lanacif/Single-Point-LiDAR-Scanner/imgs/Resultado1.png

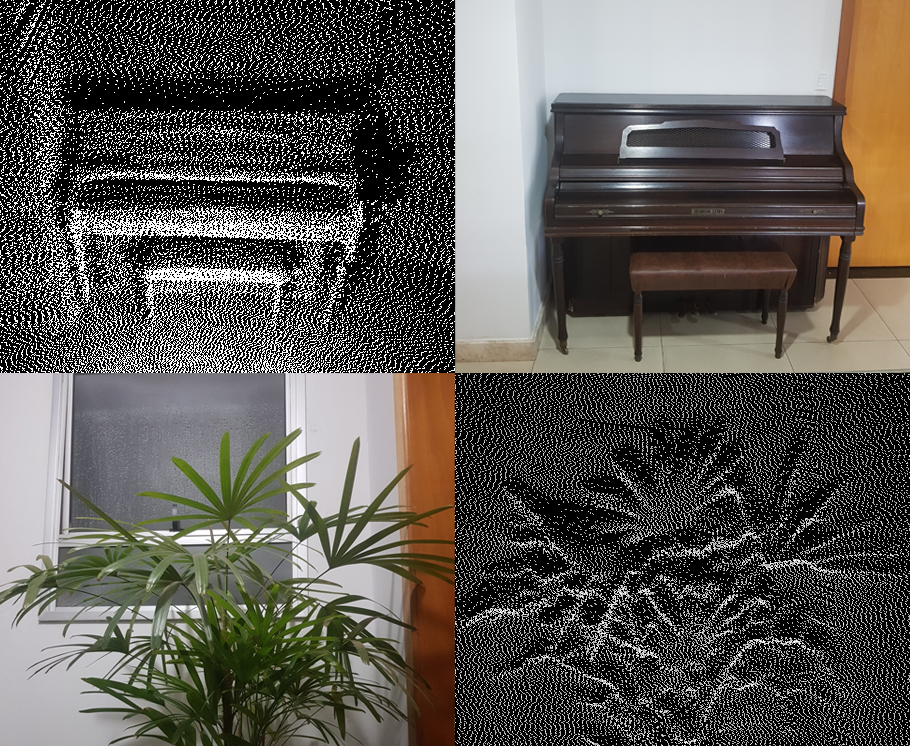
imgs/Resultado1.png
