lanacif/Single-Point-LiDAR-Scanner/README.md

# Single-Point-LiDAR-Scanner
Este repositório contém o código e os recursos necessários para o desenvolvimento de um protótipo de scanner LiDAR terrestre estacionário de ponto único, projetado para estudos e mapeamento de ambientes em pequena escala.
