lanacif/Single-Point-LiDAR-Scanner/Artigos Guia/TCC2.pdf

Centro Federal de Educaçao Tecnol ˜ | ogica de Minas Gerais – CEFET-MG ´ | 1
Construçao e Caracterizaç ˜ | ao de Sensores LiDAR no ˜

# Mapeamento 3D de Ambientes

Lucas Augusto Nacif Moura, CEFET-MG

Resumo—Este estudo descreve o desenvolvimento e a
implementaçao de um prot ˜ | otipo de scanner LiDAR terrestre ´
estacionario, que foi utilizado para avaliar o impacto do aliasing ´
espacial em funçao da resoluç ˜ | ao espacial e da dist ˜ | ancia de ˆ
mediçao. Experimentos realizados a dist ˜ | ancias de 1 m, 2 m ˆ
e 4 m revelaram uma tendencia de incremento do aliasing ˆ
com o aumento da distancia, evidenciando a correlaç ˆ | ao entre a ˜
distancia de mediç ˆ | ao e diminuiç ˜ | ao da resoluç ˜ | ao espacial. Esta ˜
constataçao ressalta a import ˜ | ancia de uma escolha criteriosa ˆ
da taxa de amostragem para assegurar a integridade do sinal amostrado. Complementando os achados experimentais, coletas realizadas com o prototipo realçam sua capacidade de criar ´ nuvens de pontos detalhadas, enfatizando sua eficacia na captura ´ dos detalhes mais relevantes dos ambientes mapeados. Diante dos resultados obtidos, este trabalho oferece uma compreensao dos ˜ desafios associados ao aliasing espacial, especialmente no contexto de scanners LiDAR terrestres estacionarios. Paralelamente, o ´
prototipo desenvolvido se destaca por sua efic ´ | acia, demonstrando ´
um equilíbrio otimizado entre custo, desempenho, funcionalidade, leveza e capacidade de transmissao de dados em tempo real. ˜ Index Terms—Scanner LiDAR, Stationary Terrestrial, Aliasing, Resolution.
I. INTRODUÇ AÕ
A

tecnologia LiDAR (Light Detection and Ranging) é uma maneira de capturar e interpretar dados espaciais,
gerando representaçoes tridimensionais realistas atrav ˜ | es de ´
nuvens de pontos. Utilizada em diversas areas como engenha- ´ ria civil, arqueologia, monitoramento ambiental, mineraçao e ˜ agricultura, a tecnologia LiDAR proporciona um mapeamento detalhado e versatil do ambiente. ´
Embora a necessidade de exigencia de precis ˆ | ao possa va- ˜
riar significativamente entre diferentes aplicaçoes, a resoluç ˜ | aõ
espacial e um atributo fundamental em levantamentos usando ´ scanners LiDAR. A resoluçao espacial determina quais de- ˜
talhes sao identific ˜ | aveis em uma nuvem de pontos obtida ´
por escaneamento LiDAR. O conhecimento correto desta
resoluçaõ e necess ´ | ario para prevenir o aliasing, permitindo ´
uma avaliaçao de quais detalhes que podem ser capturados da ˜ nuvem de pontos.
Conforme Lichti [1], a resoluçao em scanners LiDAR ˜ e frequentemente mal interpretada e calculada de maneira ´

Lucas Augusto Nacif Moura, (http://lattes.cnpq.br/1147778298578569) Belo Horizonte, Minas Gerais (lanacif@hotmail.com)
Trabalho de Conclusao de Curso submetido em 04/12/2023 e orientado ˜ pelo Dr. Everthon de Souza Oliveira, (http://lattes.cnpq.br/5508538577119686) e coorientado pelo Dr. Tulio Charles ´ de Oliveira Carvalho (http://lattes.cnpq.br/0249563467742892) integrantes do Departamento de Engenharia Eletrica (http://www.eng-eletrica.bh.cefetmg.br/) do ´ (http://www.eng-eletrica.bh.cefetmg.br/)
Centro Federal de Educaçao Tecnol ˜ | ogica de Minas Gerais. ´ (https://www.cefetmg.br/)
“E nao vos conformeis com este mundo, mas transformai-vos pela renovaç ˜ | aõ
do vosso entendimento, para que experimenteis qual seja a boa, agradavel e ´ perfeita vontade de Deus.” Romanos 12:2
incorreta. E destacado que a ´ | enfase excessiva ˆ | e comumente co- ´
locada no menor intervalo de amostragem possível, ignorando fatores cruciais como a largura do feixe do laser. Tal malentendido atribui erroneamente uma alta resoluçao espacial ˜ em nuvens de pontos escaneadas, mesmo quando a largura do feixe compromete a qualidade da resoluçao. Para evitar ˜ tais equívocos e fornecer uma compreensao mais apropriada e ˜ abrangente da resoluçao em scanners a laser, Lichti [1] intro- ˜ duz um novo metodo chamado “Effective Instantaneous Field ´
of View” (EIFOV). Esse metodo prop ´ | | oe integrar consideraç ˜ | oes ˜
da largura do feixe e do intervalo de amostragem para uma
avaliaçao mais exata da resoluç ˜ | ao. ˜
Sendo assim, este trabalho dedica-se a explorar e analisar a metodologia empregada no desenvolvimento de um scanner
LiDAR terrestre estacionario de ponto ´ | unico, sem ecos e sem ´
uma unidade de GPS. A preocupaçao com a economia de ˜
recursos sao caracter ˜ | ísticas marcantes do aparato desenvolvido
e examinado. Apos essa fase inicial, a investigaç ´ | ao avança ˜
para uma analise do fen ´ | omeno do aliasing espacial, uma ˆ
consideraçao essencial para a compreens ˜ | ao das operaciona- ˜
lidades e limitaçoes inerentes ao dispositivo. ˜
Na sequencia, uma avaliaç ˆ | aõ e conduzida sobre o prot ´ | | otipo ´
desenvolvido, utilizando-se o metodo EIFOV para estabelecer ´
a resoluçao. Complementando a investigaç ˜ | ao, um teste pr ˜ | atico ´
e realizado com o objetivo de observar a ocorr ´ | encia e a ˆ
manifestaçao do efeito aliasing no contexto de mediç ˜ | | | oes ˜
LiDAR.
II. ASPECTOS TECNICOS E ´ | OPERACIONAIS DO SCANNER
| LIDAR
A. Scanner LiDAR Aereo e Terrestre: A Tecnologia e ´ Princípios Basicos ´
O sistema LiDAR, frequentemente utilizado em aeronaves de asa fixa, compreende um scanner com emissor e receptor de laser. Ele e integrado a um Sistema de Posicionamento ´ Global (GPS) para medir continuamente a localizaçao do ˜ scanner, essencial na determinaçao da origem dos pulsos laser. ˜
Alem disso, uma Unidade de Mediç ´ | ao Inercial (IMU) ˜ | e usada ´
para monitorar as variaçoes angulares da aeronave, como ˜ rolamento, arfagem e guinada, fornecendo dados para calcular
a orientaçao da aeronave e, por extens ˜ | ao da direç ˜ | ao dos pulsos ˜
emitidos [12].
Para compreender os princípios do LiDAR, e instrutivo ´ observar o trajeto de um pulso de luz individual. Este pulso é
formado por fotons cronometrados, disparados em uma direç ´ | | | aõ
predeterminada. Ao interagir com um objeto, como uma folha
na floresta, uma fraçao dos f ˜ | otons ´ | e refletida em direç ´ | aõ à
Trabalho de Conclusao de Curso - Engenharia El ˜ | etrica ´

Centro Federal de Educaçao Tecnol ˜ | ogica de Minas Gerais – CEFET-MG ´ | 2

fonte laser. O sistema LiDAR detecta esses fotons refletidos, ´ registrando o momento de seu retorno e calculando o intervalo
de tempo desde sua emissao at ˜ | e a recepç ´ | ao. Este processo ˜ | é
conhecido como ”eco”, originado do pulso emitido. Usando a velocidade conhecida do pulso (equivalente a velocidade da `
luz), o local de emissao, a direç ˜ | ao e o tempo de viagem do ˜
pulso, o LiDAR determina o ponto de origem do eco. [12]. Os pulsos de luz podem gerar multiplos retornos luminosos, ´ pois alguns feixes penetram materiais parcialmente transparentes antes de refletir em outros objetos. Esses ecos saõ classificados em quatro categorias: “primeiro de muitos” (o
primeiro eco dentre varios), “ ´ | ultimo de muitos” (o ´ | ultimo eco), ´
“intermediario” (ecos entre o primeiro e o ´ | ultimo) e “ ´ | unico” ´
(quando apenas um eco e detectado a partir de um pulso) [12]. ´
A localizaçao de cada eco ˜ | e registrada, associando-se ´ | as`
coordenadas XYZ correspondentes. Esses dados coletados saõ comumente processados sob a forma de uma nuvem de pontos.
Mediante a representaçao gr ˜ | afica desses dados, torna-se vi ´ | avel ´
a visualizaçao da estrutura do objeto que passou pelo processo ˜ de digitalizaçao [12]. ˜
Embora o scanner LiDAR aereo seja uma ferramenta po- ´ derosa para a captaçao de dados em grande escala, sua ˜ contraparte terrestre oferece uma perspectiva complementar.
Os fundamentos da mediçao de dist ˜ | ancia a laser e varredura ˆ
apresentados se aplicam tanto a sistemas aereos quanto a ´ sistemas terrestres.
A tecnologia LiDAR terrestre, oferece um nível de detalhe
e precisao distintos. Enquanto o LiDAR a ˜ | ereo ´ | e ideal para ´
mapeamentos de grande escala e analises extensas de ´ | areas, o ´
LiDAR terrestre se destaca em levantamentos mais detalhados em escalas menores. Frequentemente utilizado em projetos de engenharia, arquitetura e arqueologia, o LiDAR terrestre opera
com scanners montados em tripes ou plataformas m ´ | oveis, per- ´
mitindo mediçoes detalhadas e de alta resoluç ˜ | ao de estruturas, ˜
terrenos e objetos proximos. Esta tecnologia complementar ´
amplia a capacidade de analise e representaç ´ | ao do mundo ˜
físico.
Enquanto os scanners a laser aereos necessitam apenas ´ de uma direçao de varredura, com a outra realizada pelo ˜ movimento da aeronave, os terrestres normalmente empregam um sistema de varredura 2D. Ha tr ´ es tipos principais: janela ˆ (usualmente operados por dois espelhos de galvanometro, ˆ
oferecendo um campo de visao retangular), panor ˜ | amicos (com ˆ
visao horizontal de 360 graus e vertical tipicamente entre 80 a ˜ 90 graus, frequentemente utilizando uma roda poligonal para a varredura vertical e uma rotaçao horizontal completa do ˜ dispositivo. A substituiçao da roda poligonal por um sistema ˜ de varredura Palmer expande o campo de visao, sendo limitado ˜
somente pelas auto-oclusoes do instrumento e do trip ˜ | e que o ´
suporta) e (hemi)esfericos [13]. ´
B. Fundamento do Funcionamento de um Scanner LiDAR Estacionario ´
Conforme apresentado, os sistemas de varredura a laser
funcionam atraves da emiss ´ | ao de feixes de luz intensos e ˜
focalizados, realizando mediçoes baseadas no tempo requerido ˜
para a captura dos reflexos pelo sensor. Essas informaçoes s ˜ | aõ
empregadas na determinaçao das dist ˜ | ancias em relaç ˆ | ao aos ˜
objetos analisados. As coordenadas tridimensionais desses ob-
jetos sao estabelecidas levando em consideraç ˜ | ao os seguintes ˜
parametros: ˆ
1) A discrepancia temporal entre a emiss ˆ | ao e o retorno do ˜
pulso de laser,
2) o angulo espec ˆ | ífico em que o pulso de laser foi proje-
tado, e
3) a posiçao absoluta do sensor, situado na ou elevado ˜ acima da superfície terrestre [3].
Um escaneamento 3D de uma cena pode ser realizado movimentando mecanicamente o feixe de laser do telemetro ˆ em passos arcuais uniformes nos planos horizontal (∆θ) e vertical (∆α), conforme delineado por Besl [4]. Este procedimento permite a parametrizaçao da cena escaneada em ˜
termos de distancia, ˆ | ρ, sendo representada como uma funçaõ
uniformemente amostrada baseada na direçao horizontal, ˜ | θ, e
no angulo de elevaç ˆ | ao, ˜ | α:

ρs(θ, α) = X∞

m=−∞

X∞

n=−∞

ρc(m∆θ, n∆α)δ(θ−m∆θ, α−n∆α)

(1)
em que ρs representa a cena contínua ρc apos a amostragem, ´ e δ simboliza a funçao delta de Dirac. Os intervalos de amos- ˜ tragem espacial variam proporcionalmente com a distancia ˆ
medida. Assim, ρ∆θ e ρ∆α indicam essa variaçao na direç ˜ | aõ
horizontal e no angulo de elevaç ˆ | ao, respectivamente. ˜
A Figura 1 ilustra o exposto anteriormente. Na Figura, é evidenciado um plano retangular e as amostras obtidas no espaço tridimensional, com incrementos uniformes para θ e α.
O telemetro est ˆ | a centrado no ponto (0,0,0), que ´ | e destacado ´
na figura.

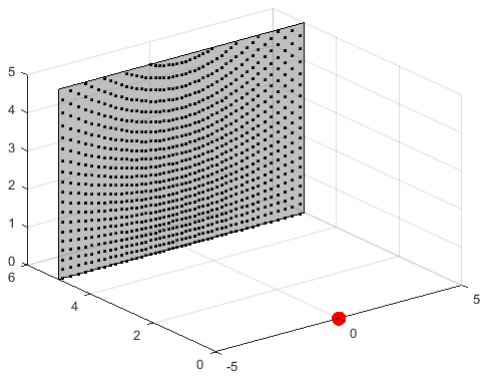
[picture p3: figure]

Figura 1. Visualizaçao tridimensional da amostragem pelo LiDAR, desta- ˜
cando a variaçao do espaçamento entre as amostras com a dist ˜ | ancia. ˆ
Este fenomeno ocorre devido ˆ | a depend ` | encia do espaçamento ˆ
entre os pontos, em termos de distancia linear, com a dist ˆ | ancia ˆ

Centro Federal de Educaçao Tecnol ˜ | ogica de Minas Gerais – CEFET-MG ´ | 3

do scanner. Proximamente ao LiDAR, uma alteraçao angular ˜ modesta pode resultar em um deslocamento linear relativa-
mente pequeno. Entretanto, a medida que a dist ` | ancia em ˆ
relaçao ao LiDAR aumenta, a mesma mudança angular pode ˜ levar a um deslocamento linear significativamente maior.

III. FUNDAMENTAÇ AÕ TEORICA ´

A. A Transformada Discreta de Fourier
Uma funçao cont ˜ ínua f(x) pode ser discretizada atraves de ´ uma serie de amostras, cada uma separada por um intervalo ´
∆x. A representaçao discreta dessa funç ˜ | aõ e expressa por: ´
f(x) = f(x0 + x∆x), | (2)
em que, neste contexto, x e uma vari ´ | avel discreta que assume ´
valores de 0 a N −1. Aqui, x0 e o ponto inicial de amostragem ´ e ∆x e o espaçamento entre as amostras, ambos sendo ´ valores constantes. Em termos simples, toma-se N amostras uniformemente espaçadas da funçao cont ˜ ínua correspondente. Dada a notaçao anterior, o par de transformadas discretas ˜
de Fourier para funçoes amostradas s ˜ | ao expressas por: ˜

F(u) = 1
N

N

X⁻¹

x=0

f(x)e

(−j2πux/N)
(3)

e

f(x) =

N

X⁻¹

u=0

F(u)e

(j2πux/N)
. | (4)
Na Equaçao 3, os valores de ˜ | u correspondem a amostras de
uma transformada contínua, isto e,´ F(u) = F(u∆u).
Os termos ∆u e ∆x estao relacionados pela seguinte ˜ expressao: ˜

∆u =

1
N∆x
. | (5)

Para um par de variaveis, o conjunto correspondente de ´ transformadas de Fourier e expresso como: ´

F(u, v) = 1
MN

M

X⁻¹

x=0

N

X⁻¹

y=0

f(x, y)e

−j2π(ux/M+vy/N)
(6)

e

f(x, y) =

M

X⁻¹

u=0

N

X⁻¹

v=0

F(u, v)e

j2π(ux/M+vy/N)
. | (7)
A captura de amostras de uma funçao cont ˜ | ínua e realizada ´
sobre uma matriz bidimensional, com intervalos de amostragem ∆x e ∆y ao longo dos eixos x e y, respectivamente. A correspondencia entre os incrementos de amostragem nos ˆ domínios espacial e de frequencia ˆ e estabelecida pelas seguin- ´ tes relaçoes: ˜

∆u =

1
M∆x

(8)

e

∆v =

1
N∆y

(9)

B. Teorema da Convoluçaõ
A operaçao matem ˜ | atica conhecida como convoluç ´ | ao entre ˜
duas funçoes ˜ | f e g, simbolizada por (f ∗ g)(x), e estabelecida ´
atraves da seguinte express ´ | ao integral: ˜
(f ∗ g)(x) = Z ∞

−∞

| | f(α) · g(x − α) dα. | (10)
No domínio da frequencia, a convoluç ˆ | ao corresponde ao ˜
produto das transformadas de Fourier das funçoes originais, ˜ ou seja,
f(x) ∗ g(x) ⇔ F(u)G(u). | (11)
Analogamente, a convoluçao no dom ˜ | ínio da frequencia se ˆ
reduz a produtos no domínio x; isto e,´
f(x)g(x) ⇔ F(u) ∗ G(u). | (12)

Similarmente, no domínio discreto, o teorema da
convoluçao mant ˜ | em a correspond ´ | encia entre a convoluç ˆ | aõ
no domínio x e a multiplicaçao no dom ˜ | ínio da frequencia, ˆ
ajustando-se as vari ` | aveis discretas apropriadas. ´
No contexto de funçoes discretas, em especial no caso ˜
bidimensional, a convoluçao entre duas funç ˜ | oes ˜ | f(x, y) e
g(x, y) e definida por uma soma dupla sobre um conjunto ´ de valores discretos. A convoluçao discreta 2-D pode ser ˜ formulada como:

fe(x, y)∗ge(x, y) = 1
MN

M

X⁻¹

m=0

N

X⁻¹

n=0

fe(m, n)ge(x−m, y−n).

(13)
em que M e N sao per ˜ | íodos escolhidos de acordo
com criterios que evitam o sobreposiç ´ | ao dos per ˜ | íodos na
convoluçao, denominado “erro de revestimento”. As funç ˜ | oes ˜
estendidas fe e ge sao vers ˜ | oes periodicamente estendidas de ˜
f e g, respectivamente, com zeros adicionados para formar matrizes de tamanho M × N.
C. Amostragem e o Teorema Homonimo ˆ
A Transformada de Fourier, em conjunto com o Teorema
da Convoluçao, prov ˜ | e instrumental anal ˆ | ítico para a exploraçaõ
do processo de amostragem de imagens. Essencialmente, o
foco da investigaçao reside na determinaç ˜ | ao da quantidade ˜
otima de amostras requeridas para assegurar que a integridade ´ informativa seja mantida durante a amostragem. Sob uma otica ´ alternativa, este desafio pode ser descrito como a definiçao de ˜
criterios de amostragem que permitam a reconstruç ´ | ao com- ˜
pleta da imagem contínua a partir de suas amostras discretas [10].
Ao considerar uma funçaõ f(x) que e cont ´ ínua, de banda limitada e definida sobre todo o conjunto dos numeros reais, ´ estendendo-se de −∞ a ∞, a respectiva versao amostrada ˜
pode ser obtida atraves da multiplicaç ´ | ao de ˜ | f(x) por uma

Centro Federal de Educaçao Tecnol ˜ | ogica de Minas Gerais – CEFET-MG ´ | 4
funçao de amostragem ˜ | s(x). Esta funçao de amostragem ˜ | é
definida como um trem de impulsos com intervalos regulares
de ∆x. Segundo o teorema da convoluçao, tal multiplicaç ˜ | aõ
no domínio de x equivale a uma convoluçao no dom ˜ | ínio da
frequencia [10]. ˆ
A transformada resultante da mencionada multiplicaçaõ
manifesta-se como uma funçao peri ˜ | odica, com um per ´ | íodo
expresso por 1/∆x, e dependendo da taxa de amostragem,
as repetiçoes individuais de ˜ | F(u) tem a possibilidade de ˆ
sobreposiçao, um fen ˜ | omeno conhecido como aliasing [10]. ˆ
Diante dessa discussao, conforme delineado por Nyquist ˜
[11] e posteriormente formalizado por Shannon [2], a amostragem efetiva de um sinal requer uma taxa que seja pelo menos
o dobro da frequencia m ˆ | axima presente no sinal anal ´ | ogico ´
original para que a reconstruçao seja teoricamente perfeita. ˜ Portanto, para evitar o efeito aliasing o intervalo de amostragem deve ser selecionado de forma que:

∆x ≤

1
2W
, | (14)
em que W e a m ´ | axima frequ ´ | encia do sinal. ˆ
Em situaçoes pr ˜ | aticas, a amostragem de uma funç ´ | aõ | é
comumente restringida a uma regiao finita, o que implica ˜ consideraçoes adicionais mesmo quando o espaçamento entre ˜ as amostras atende ao teorema da amostragem para prevençaõ
do aliasing. A limitaçao da extens ˜ | ao da amostragem, ˜ | e operaci- ´
onalizada pela multiplicaçao da funç ˜ | ao no dom ˜ | ínio x com uma
funçao janela que abrange o intervalo [0, X]. A transformada ˜
de Fourier desta funçao janela, devido ˜ | a sua forma retangular, `
exibe lobulos secund ´ | arios que se estendem indefinidamente em ´
ambas as direçoes do eixo da frequ ˜ | encia. Essa caracter ˆ | ística
impoe uma influ ˜ | encia no espectro de frequ ˆ | encia do sinal ˆ
amostrado, uma vez que a convoluçao do espectro do sinal ˜
com a transformada de Fourier da funçao janela n ˜ | ao se ˜
restringe ao lobulo principal, mas tamb ´ | em incorpora os l ´ | obulos ´
secundarios. O espectro de frequ ´ | encia resultante, portanto, ˆ
contem componentes adicionais que permeiam todo o dom ´ | ínio
da frequencia, comprometendo a capacidade de reconstruç ˆ | aõ
fiel do sinal original a partir de suas amostras.
Portanto, ainda que se cumpra o teorema da amostragem, a
recuperaçao integral de uma funç ˜ | ao confinada a um dom ˜ | ínio
finito x e intrinsecamente limitada. Esta observaç ´ | ao funda- ˜
menta a conclusao de que nenhuma funç ˜ | | aõ f(x) de duraçaõ
finita pode ser estritamente limitada em banda. Em contraste,
uma funçao que apresenta limitaç ˜ | ao de banda deve, por ne- ˜
cessidade teorica, estender-se de ´ | −∞ a ∞ no domínio x. Esta
conclusaõ e relevante, pois estabelece um limite fundamental ´
na manipulaçao de funç ˜ | oes digitais [10]. ˜
Os conceitos de amostragem, apos ajustes na notaç ´ | ao, s ˜ | aõ
diretamente aplicaveis a funç ´ | oes bidimensionais. O processo ˜
de amostragem para tais funçoes pode ser descrito matematica- ˜
mente pelo emprego da funçao impulso 2-D, ˜ | δ(x, y), definida
como segue [10]:

Z Z∞

−∞

f(x, y)δ(x − x0, y − y0) dx dy = f(x0, y0). (15)

Na Figura 2, que representa uma funçao bidimensional de ˜ banda limitada amostrada no domínio da frequencia, identifica- ˆ se que as medidas de largura 2Wu e 2Wv correspondem,
respectivamente, as direç ` | oes ˜ | u e v do retangulo m ˆ | ínimo que
engloba por completo a regiao R. Ent ˜ | ao, se ˜ | 1/∆x > 2Wu e
1/∆y > 2Wv, evita-se o aliasing, o que torna a reconstruçaõ do sinal possível.
Em diferentes termos, a reconstruçao integral de uma funç ˜ | aõ
de banda limitada f(x, y) e poss ´ | ível quando se dispoe de um ˜
conjunto de amostras, cujos intervalos satisfazem, simultaneamente, as seguintes condiçoes: ˜

∆x ≤

| | 1 2Wu | (16)

e

∆y ≤

| | 1 2Wv
| | . | (17)

Quando a funçaõ f(x, y) e espacialmente limitada por uma ´ janela bidimensional, a transformada da funçao amostrada ˜
sofre distorçao. Esta distorç ˜ | ao, intr ˜ | ínseca a natureza espaci- `
almente limitada das imagens digitais, restringe a recuperaçaõ completa de f(x, y) a partir do conjunto de suas amostras [10].

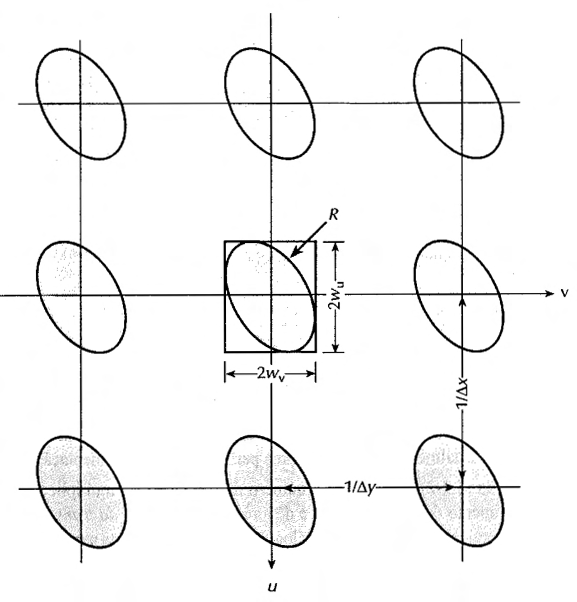
[picture p4: figure]

Figura 2. Visualizaçao no dom ˜ | ínio da frequencia de uma funç ˆ | ao bidimensi- ˜
onal de banda limitada amostrada. Fonte: Gonzalez e Woods [10].

Centro Federal de Educaçao Tecnol ˜ | ogica de Minas Gerais – CEFET-MG ´ | 5
IV. PROTOTIPO ´ | DESENVOLVIDO
A. Objetivos e Requisitos
O prototipo desenvolvido apresenta como principal obje- ´
tivo a representaçao fiel de pequenos ambientes atrav ˜ | es de ´
nuvens de pontos. Esta representaçao leva em consideraç ˜ | aõ
as limitaçoes dos sensores e equipamentos de baixo custo ˜ empregados. O foco esta em alcançar uma fidelidade adequada ´ na captura dos detalhes mais relevantes do ambiente.
Alem disso, o projeto inclui a implementaç ´ | ao de uma ˜
representaçao gr ˜ | afica em tempo real e sincronizada em um ´
computador, proporcionando uma visualizaçao imediata dos ˜ dados adquiridos pelo sensor. Essa representaçao inclui tanto ˜
os dados ja capturados quanto aqueles que est ´ | ao sendo obtidos ˜
em tempo real.
Quanto aos requisitos do prototipo, destaca-se a import ´ | ancia ˆ
de sua leveza. O design do prototipo objetiva ser suficien- ´ temente leve para ser transportado por drones comuns. Esta característica amplia significativamente as possibilidades de aplicaçao do sensor LiDAR em diversos contextos, como o ˜
mapeamento de areas remotas ou de dif ´ | ícil acesso.
Outro aspecto importante e a efici ´ | encia na transmiss ˆ | aõ
e processamento dos dados do sensor LiDAR, que deve garantir a representaçao gr ˜ afica em tempo real. Este recurso ´ proporciona uma experiencia imersiva e permite a tomada de ˆ
decisoes ˜ | ageis, seja por um usu ´ | ario humano ou por sistemas ´
automatizados, como, por exemplo, os que sao fundamentados ˜ em tecnicas avançadas de reconhecimento de imagem. ´
Considerando as condiçoes ambientais, o prot ˜ | otipo, embora ´
nao apresente resist ˜ | encia ˆ | à agua ou poeira, foi desenvolvido ´
para operar de maneira eficaz em condiçoes ambientais nor- ˜ mais. Esse design visa garantir tanto a integridade do sistema quanto a sua eficiencia em ambientes controlados. ˆ
B. Componentes-chave e Integraçao Funcional ˜
O prototipo desenvolvido, mostrado na Figura 7, faz uso ´ dos seguintes componentes-chave:
- Servomotor SG92R TowerPro;
- Motor de passo 28BYJ-48;
- Sensor de distancia TF-Luna baseado na t ˆ | ecnica “Time ´
of Flight” (ToF);
- Microcontrolador ESP32-WROOM-32D;
- Sensor de posiçao angular magn ˜ | etico AS5600. ´
Uma lista completa dos componentes utilizados, com com os preços encontrados para esse projeto, e mostrada na Tabela ´ III, no apendice. ˆ
O prototipo do scanner LiDAR foi projetado com um foco ´ em desempenho, custo e funcionalidade. O microcontrolador ESP32 foi escolhido como controlador central do prototipo ´ devido a sua robusta gama de recursos, incluindo suporte ` para modulaçao por largura de pulso (PWM), capacidade ˜ de conexao Wi-Fi, suporte ao protocolo MQTT (Message ˜ Queuing Telemetry Transport), suporte a comunicaçao I2C ˜ (Inter-Integrated Circuit) e adequada capacidade de processamento, tornando-o ideal para o controle e comunicaçao do ˜ dispositivo.

O servomotor SG92R TowerPro foi modificado para permitir um giro contínuo, atendendo a necessidade de ajustar `
o angulo horizontal ˆ | θ. A escolha do SG92R foi baseada em
sua leveza e facilidade de controle. A posiçao do servomotor ˜
e determinada pelo sensor de posiç ´ | ao magn ˜ | etico AS5600, ´
selecionado pela sua capacidade de mediçao precisa sem ˜ contato físico.
Para o controle do angulo de elevaç ˆ | aõ α, optou-se pelo
uso do motor de passo 28BYJ-48. Este tipo de motor permite o controle preciso da posiçao angular, mesmo sem ˜
realimentaçao, o que reduz as incertezas nas mediç ˜ | oes an- ˜
gulares do scanner LIDAR.

O software Unity foi escolhido para a visualizaçao de dados ˜ em tempo real devido ao seu amplo suporte a scripts, versatilidade e capacidade de renderizar ambientes tridimensionais complexos de maneira eficiente.

Para a comunicaçao entre o hardware e o software, optou-se ˜ pelo broker MQTT Eclipse Mosquitto, dada a sua gratuidade, robustez e conjunto completo de funcionalidades. Este broker facilita a transmissao eficiente de dados entre o scanner LiDAR ˜
e o sistema de visualizaçao, suportando a comunicaç ˜ | ao em ˜
tempo real necessaria para o projeto. ´

Finalmente, o sensor de distancia TF-Luna foi escolhido ˆ
para o prototipo devido ´ | a sua alta resoluç ` | ao, campo de vis ˜ | aõ
(FOV) adequado e custo-benefício.

Para melhor compreensao do dispositivo elaborado, a Figura ˜
3 ilustra o diagrama de conexoes realizadas, com a supress ˜ | aõ
de alguns detalhes e componentes menos relevantes, como o
circuito de inicializaçao e o circuito de bootloader. Al ˜ | em disso, ´
a Figura 4 representa as logicas de programaç ´ | ao implementa- ˜
das no ESP32 e no Unity, as quais detalham o funcionamento do sistema.

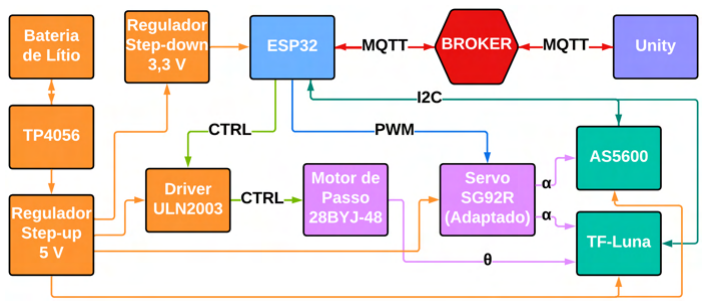
[picture p5: figure]

Figura 3. Diagrama de elementos e conexoes. ˜

Centro Federal de Educaçao Tecnol ˜ | ogica de Minas Gerais – CEFET-MG ´ | 6

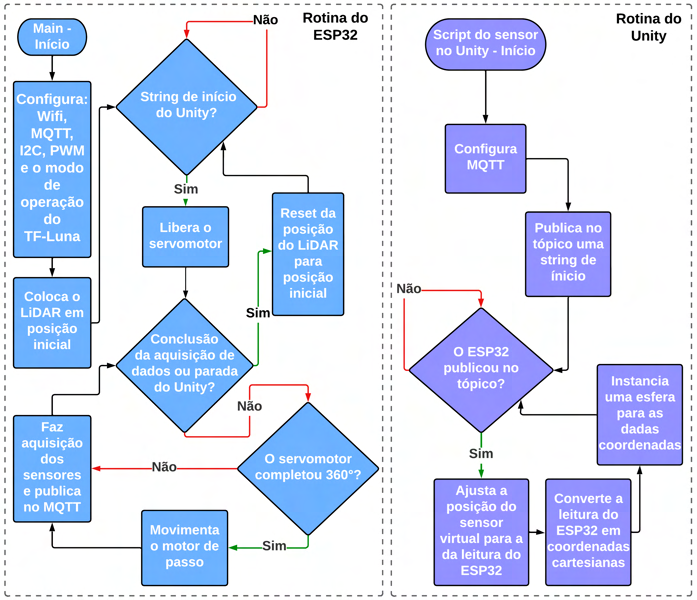
[picture p6: figure]

Figura 4. Fluxograma de funcionamento.

C. Adaptaçao do Servomotor ˜

Para possibilitar que o servo motor, designado para o
ajuste do angulo ˆ | θ, efetue uma rotaçao cont ˜ | ínua de
360 °, procedeu-se a remoç ` | ao do potenci ˜ | ometro de ˆ
feedback, que estava mecanicamente acoplado ao eixo de saída. Em substituiçao, instalaram-se dois resistores ˜ de 2 kΩ em seus terminais, conforme ilustrado na Figura 5. Tal configuraçao induz o controlador do servo ˜ motor a interpretar uma posiçao fixa de 90 °. Com essa ˜
modificaçao, a modulaç ˜ | ao por largura de pulso (PWM) ˜
e agora aplicada para controlar a velocidade e a direç ´ | aõ
de rotaçao do servo motor. Inicialmente, considerou-se ˜ a possibilidade de utilizar os terminais remanescentes
do potenciometro, j ˆ | a que o mesmo estava conectado ´
mecanicamente ao eixo do servomotor, para determinar a posiçao angular do mesmo. Contudo, constatou-se que ˜
o alcance eletrico do potenci ´ | ometro limitava-se a 330 °, ˆ
o que nao satisfazia a exig ˜ | encia de uma amplitude total ˆ
de 360 °. Dessa forma, tornou-se necessario identificar ´ uma metodologia alternativa que permitisse a aferiçaõ da posiçao angular do servo motor. Para superar essa ˜
limitaçao, optou-se pela implementaç ˜ | ao do sensor de ˜
rotaçao sem contato AS5600. Um circuito espec ˜ | ífico
foi concebido para prover o sensor com a tensao ope- ˜ racional de 5 V, e a placa de circuito correspondente e apresentada na Figura 5. Esta placa de circuito foi ´ projetada para ser facilmente incorporada a estrutura ` existente do servo motor. A utilizaçao do sensor AS5600 ˜
demanda a instalaçao de um ˜ | íma de neod ˜ | ímio no eixo
do motor, e o posicionamento subsequente do sensor a uma distancia controlada de 0,5 a 3 mm abaixo do ˆ
íma. Tal procedimento exigiu a remoç ˜ | ao pr ˜ | evia de quais- ´
quer componentes metalicos que compunham a estrutura ´ original do potenciometro. Posteriormente, procedeu-se ˆ
com a fixaçao do ˜ | íma na parte m ˜ | ovel da estrutura do ´

potenciometro, que se acopla perfeitamente ao eixo de ˆ saída do servo motor. A Figura 6 ilustra o servo motor
apos a execuç ´ | ao das modificaç ˜ | oes necess ˜ | arias. ´

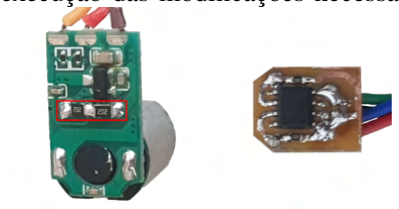
[picture p7: figure]

Figura 5. A esquerda, os resistores conectados aos terminais em que antes `
estava o potenciometro de feedback; ˆ | a direita, a placa de circuito contendo o `
sensor AS5600.

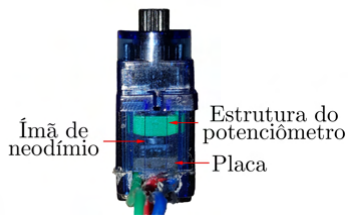
[picture p8: figure]

Figura 6. Servo motor apos as adaptaç ´ | oes. ˜
D. Estrutura do Prototipo ´
A estrutura física do prototipo foi concebida de modo ´ que nao ocorra o emaranhamento dos cabos, possibilitando ˜
uma rotaçao completa de 360 ° | com relaç ˜ | aõ | a base do `
prototipo e de 180 °ao longo do eixo do sensor. As partes ´
que compoem essa estrutura s ˜ | ao mostradas na Figura 18. O ˜
Polietileno Tereftalato de Glicol (PETG) foi escolhido como
material de construçao, devido ˜ | a sua resist ` | encia e leveza. o ˆ
sensor foi centralizado nos eixos rotativos, gerando um ponto
cego onde o prototipo s ´ | o consegue visualizar sua estrutura ´
interna em certos angulos de elevaç ˆ | aõ α. Diante disso, sugere-
se o reposicionamento do eixo do servomotor superior para eliminar esses pontos cegos. Essa alteraçao requer ajustes nas ˜
coordenadas esfericas para garantir maior exatid ´ | | ao do sistema. ˜

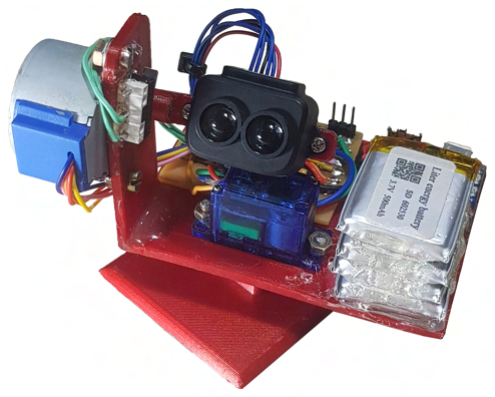
[picture p9: figure]

Figura 7. Prototipo desenvolvido. ´

Com um peso total de 123 gramas, o prototipo demonstrou ´ ser suficientemente leve para aplicaçoes que exigem mobi- ˜ lidade, como o uso em drones. Esta característica satisfaz o requisito de portabilidade e amplia significativamente as possibilidades de uso do sensor LiDAR em variados contextos,
incluindo mapeamentos em areas remotas ou de dif ´ | ícil acesso.

Centro Federal de Educaçao Tecnol ˜ | ogica de Minas Gerais – CEFET-MG ´ | 7
V. ANALISE DA ´ | RESOLUÇ AÕ
A. Especificaçoes de Alcance e Resoluç ˜ | ao dos Componentes ˜
Determinantes do Sistema
A eficacia de um scanner LiDAR ´ | e intrinsecamente ligada ´
as caracter ` | ísticas tecnicas de seus componentes. Na Tabela I, ´
sao destacadas as especificaç ˜ | oes de alcance e resoluç ˜ | ao dos ˜
elementos essenciais que constituem o prototipo, sublinhando ´
a importancia de cada um para a acur ˆ | acia e a performance ´
do sistema. Estes parametros s ˆ | ao cruciais, pois estabelecem ˜
os limites operacionais e a precisao das mediç ˜ | oes realizadas. ˜

Tabela I
COMPONENTES, VARIAVEIS ´ | ASSOCIADAS E ESPECIFICAÇ OES DE ˜
| RESOLUÇ AÕ
Componente | Variavel ´ | Alcance | Resoluçaõ
AS5600 | θ | 0-360 ° | 0,0879 °
28BYJ-48 | α | 0-180 ° | 0,0879 °
TF-Luna | ρ | 0,2-8 m | 1 cm
B. Determinaçao da Resoluç ˜ | ao atrav ˜ | es do M ´ | etodo EIFOV ´
Ressalta-se que, na metodologia adotada a resoluçao do ˜
prototipo, considera a largura do feixe do laser. A dimens ´ | aõ
deste feixe, no contexto do sensor implementado, e definida ´
conforme a expressao matem ˜ | atica: ´
δ = 2 · D · tan β, | (18)
em que δ e o di ´ | ametro do feixe laser, D ˆ | e a dist ´ | ancia do objeto ˆ
e β e metade do FOV de 2°do TF-Luna. ´
Alem disso, ´ | e considerado o arco entre as amostras para a ´
distancia desejada. Que pode ser obtido como: ˆ

∆ = D ·

θπ
180
, | (19)

em que θ representa o incremento angular uniforme entre as
amostras na direçao horizontal e no ˜ | angulo de elevaç ˆ | ao, isto ˜
e,´ θ = α.
Com base nesses parametros, calculou-se a resoluç ˆ | ao espa- ˜
cial do prototipo para quatro dist ´ | ancias distintas utilizando o ˆ
metodo EIFOV. Os resultados desses c ´ | alculos s ´ | ao apresentados ˜
de forma detalhada na Tabela II.

Tabela II
RESOLUÇ AO ESPACIAL DO PROT ˜ | OTIPO CALCULADA PELO M ´ | ETODO ´
EIFOV PARA QUATRO DISTANCIAS DISTINTAS ˆ
Distancia (m) ˆ | ∆ (mm) | δ (mm) | EIFOV (mm)
1 | 1,53 | 34,91 | 30,05
2 | 3,07 | 69,82 | 60,09
4 | 6,14 | 139,64 | 120,19
8 | 12,27 | 279,28 | 240,38
VI. ESTABELECIMENTO DE UM CENARIO ´ | ESPECÍFICO
PARA AVALIAÇ AÕ

Para o estudo do fenomeno aliasing, blocos de isopor com ˆ dimensoes de 15 cm x 15 cm x 4 cm foram dispostos a ˜ intervalos regulares de 15 cm em uma superfície vertical, a fim de simular uma onda quadrada.

Para as coletas de dados, o scanner LiDAR, com seu angulo ˆ
de elevaçao fixado em 90 °, foi posicionado em tr ˜ | es dist ˆ | ancias ˆ
– 1 m, 2 m e 4 m – em relaçao aos pontos inicial e final do ˜ sinal representado pela superfície e pelos blocos de isopor, como ilustrado na Figura 8. A Figura 9 apresenta a linha escaneada, destacada em vermelho, demonstrando visualmente
a metodologia de aquisiçao dos dados para a an ˜ | alise do ´
fenomeno de aliasing. ˆ
Nessa configuraçao espec ˜ | ífica, apesar da distancia ser man- ˆ
tida linear entre o scanner e os pontos de início e termino ´ do sinal ser mantida constante, a natureza da aquisiçao esta- ˜
cionaria resultou em variaç ´ | oes de dist ˜ | ancia ao longo do sinal. ˆ
Isso ocorre porque, em uma superfície plana, os pontos mais
centrais ao campo de visao do LiDAR est ˜ | ao mais pr ˜ | oximos ´
do aparelho, enquanto os pontos mais distantes ao longo da
extensao lateral do sinal est ˜ | ao mais afastados. ˜
Para cada uma das distancias estabelecidas foi realizada ˆ uma varredura do sinal desconsiderando o eixo da altura (eixo z), resultando na coleta de um conjunto específico de dados.
Os tres conjuntos de dados obtidos permitiram uma an ˆ | alise ´
comparativa do impacto da distancia no fen ˆ | omeno de aliasing. ˆ

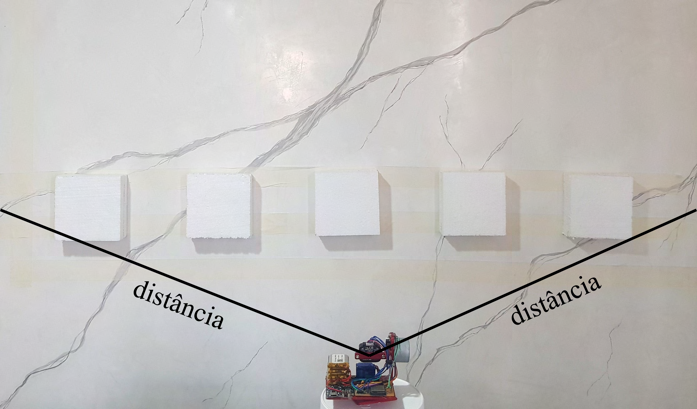
[picture p10: figure]

Figura 8. | Configuraçao experimental concebida para o estudo do efeito ˜
aliasing em mediçoes realizadas com o prot ˜ | otipo. ´

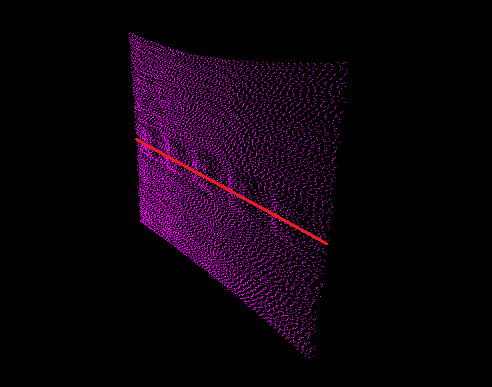
[picture p11: figure]

Figura 9. Nuvem de pontos capturada pelo prototipo, destacando em vermelho ´ a linha escaneada para estudo do aliasing.

Centro Federal de Educaçao Tecnol ˜ | ogica de Minas Gerais – CEFET-MG ´ | 8
VII. MANIPULAÇ AO E ˜ | ANALISE DOS ´ | DADOS

No conjunto de dados coletados, a posiçao angular da ˜
superfície plana em relaçao ao eixo x ˜ | e influenciada pela ´
posiçao angular do sensor no momento da varredura. Com ˜
base nessa consideraçao, realizou-se uma regress ˜ | ao linear com ˜
o objetivo de determinar a inclinaçao da superf ˜ | ície em relaçaõ
ao eixo x, conforme ilustrado na Figura 10. Apos essa an ´ | alise, ´
procedeu-se a rotaç ` | ao dos vetores x e y, de forma a alinhar o ˜
sinal perpendicularmente ao eixo x.

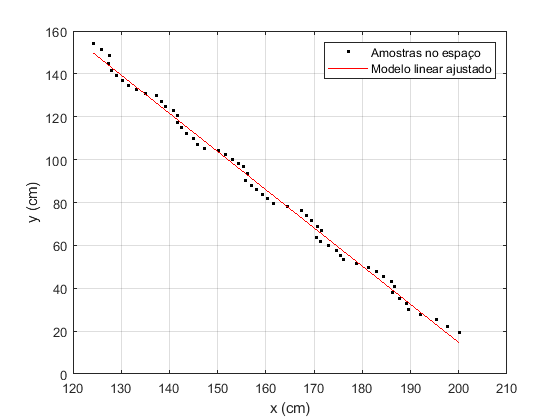
[picture p12: figure]

Figura 10. Ilustraçao da regress ˜ | ao linear para determinar a inclinaç ˜ | ao que ˜
alinha o sinal com o eixo x.
Na sequencia de manipulaç ˆ | ao dos dados, realizou-se a ˜
subtraçao do menor valor da amplitude em y do conjunto ˜ de amplitudes, visando a normalizaçao das medidas. A ˜
manipulaçao dos dados culminou na obtenç ˜ | ao de um sinal ˜
corrigido que proporcionou uma base para a analise subse- ´ quente.
Na fase de analise, plotaram-se tr ´ | es sinais distintos: o sinal ˆ
aquisitado ajustado, uma onda quadrada cuja resoluçao corres- ˜
ponde a m` edia da resoluç ´ | ao observada nos dados aquisitados, e ˜
uma onda quadrada de alta resoluçao, esta ˜ | ultima caracterizada ´
por amostras espaçadas em intervalos extremamente reduzidos.
Em sequencia, executou-se a Transformada R ˆ | apida de Fourier ´
(FFT) foi aplicada a cada um desses sinais.
A realizaçao da FFT possibilitou a avaliaç ˜ | ao das compo- ˜
nentes de frequencia dos sinais e a identificaç ˆ | ao de potenciais ˜
distorçoes devido ao aliasing espacial. Esta an ˜ | alise revelou ´
como a resoluçao espacial do sensor LiDAR influencia a ˜ integridade da informaçao e contribui para a presença de ˜ artefatos no espectro de frequencia. ˆ
VIII. ANALISE DO ´ | EFEITO ALIASING

Conforme apresentado em seçoes anteriores, foram condu- ˜ zidos experimentos em tres dist ˆ ancias-chave - 1 m, 2 m e ˆ 4 m - para avaliar o impacto da proximidade na incerteza dos dados coletados pelo sensor LiDAR e na manifestaçaõ de aliasing espacial. Para cada uma dessas distancias, os ˆ
resultados sao representados por dois conjuntos de gr ˜ | | aficos. ´

O primeiro conjunto inclui o sinal aquisitado ajustado, uma
onda quadrada com resoluçao equivalente ˜ | a m` | edia do sinal ´
aquisitado ajustado e outra de alta resoluçao. O segundo ˜
conjunto de graficos apresenta a an ´ | alise realizada por meio ´
da Transformada Rapida de Fourier (FFT) desses sinais. Os ´
graficos referentes ´ | a dist ` | ancia de 1 m est ˆ | ao dispon ˜ | íveis nas
Figuras 11 e 12, para a distancia de 2 m nas Figuras 13 e 14, ˆ e para a distancia de 4 m nas Figuras 15 e 16. ˆ

Distancia de 1 m: ˆ

No grafico do dom ´ | ínio espacial, Figura 11, o sinal adquirido
a 1 metro apresenta um perfil significativamente diferente dos sinais simulados, indicando que a taxa de amostragem pode
nao ser suficiente para capturar a frequ ˜ | encia espacial do sinal. ˆ
Isso e um sinal de aliasing, em que altas frequ ´ | encias do sinal ˆ
sao interpretadas incorretamente como baixas frequ ˜ | | | | encias, ˆ
resultando em distorçoes na forma de onda capturada. ˜
No grafico do dom ´ | | ínio da frequencia, Figura 12, eram ˆ
esperados picos claros correspondentes as frequ ` | encias funda- ˆ
mentais da onda quadrada e seus harmonicos. No entanto, o ˆ sinal adquirido mostra picos em locais que nao correspondem ˜
aos dos sinais simulados, o que e uma indicaç ´ | ao de que est ˜ | á
ocorrendo o fenomeno de aliasing nas frequ ˆ | encias. A dis- ˆ
crepancia entre as magnitudes das componentes de frequ ˆ | | | | encia ˆ
tambem sugere que as altas frequ ´ | encias est ˆ | ao dobrando para ˜
dentro da banda de frequencia amostrada, manifestando-se ˆ como artefatos no espectro de frequencia. ˆ

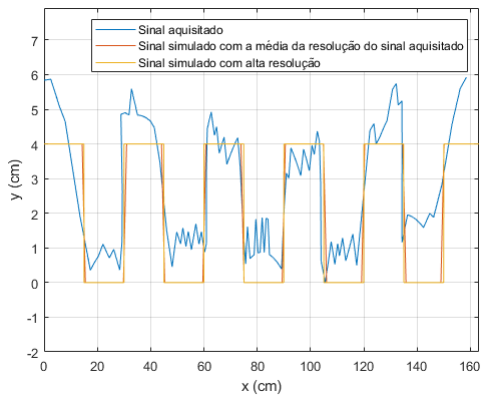
[picture p13: figure]

Figura 11. Comparaçao entre o sinal LiDAR adquirido, o sinal simulado com ˜
a media da resoluç ´ | ao do sinal adquirido e o sinal simulado com alta resoluç ˜ | aõ
a 1 metro.

Centro Federal de Educaçao Tecnol ˜ | ogica de Minas Gerais – CEFET-MG ´ | 9

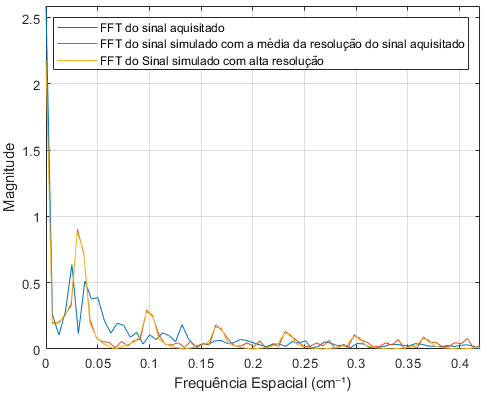
[picture p14: figure]

Figura 12. Espectro de frequencia dos sinais a 1 metro dos sinais: adquirido, ˆ
simulado com media da resoluç ´ | ao e simulado de alta resoluç ˜ | ao. ˜

Distancia de 2 m: ˆ
Com a distancia em 2 metros visto na Figura 13, a dis- ˆ crepancia entre o sinal adquirido e os sinais simulados no ˆ
grafico do dom ´ | ínio do tempo torna-se mais evidente. Isso
pode indicar que a resoluçao espacial do LIDAR ˜ | e ainda ´
menos capaz de resolver detalhes menores a esta distancia, ˆ exacerbando os efeitos de aliasing.
No grafico da Figura 14, a FFT do sinal adquirido (azul) ´
exibe picos de magnitude que nao est ˜ | ao alinhados com a FFT ˜
do sinal de alta resoluçao (amarelo), sugerindo a ocorr ˜ | encia ˆ
de aliasing. Os picos no sinal simulado com a media da taxa de amostragem (laranja) confirmam essa interpretaçao, ˜ ja que ambos os sinais azul e laranja apresentam anomalias ´
semelhantes em comparaçao a FFT do sinal de alta resoluç ˜ | aõ
(amarelo).

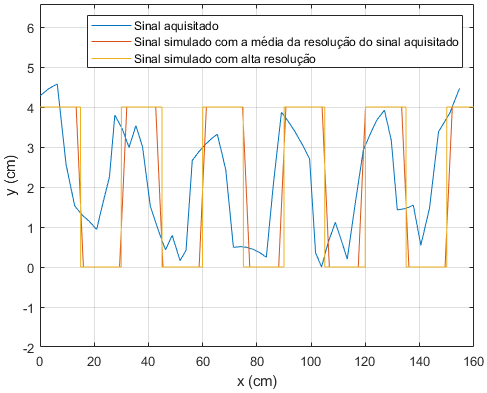
[picture p15: figure]

Figura 13. Comparaçao entre o sinal LiDAR adquirido, o sinal simulado com ˜
a media da resoluç ´ | ao do sinal adquirido e o sinal simulado com alta resoluç ˜ | aõ
a 2 metros.

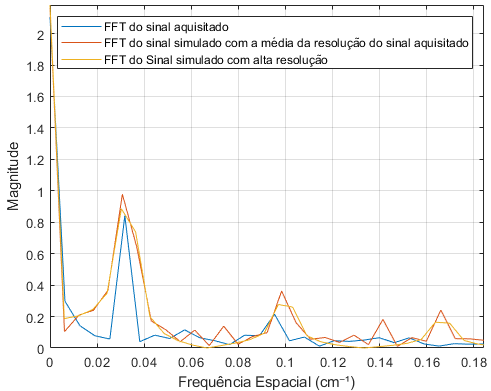
[picture p16: figure]

Figura 14. Espectro de frequencia dos sinais a 2 metros dos sinais: adquirido, ˆ
simulado com media da resoluç ´ | ao e simulado de alta resoluç ˜ | ao. ˜

Distancia de 4 m: ˆ
A 4 metros, Figura 15, o aliasing parece ser ainda mais pronunciado, com uma forma de onda capturada que naõ representa de maneira alguma a onda quadrada ideal. Isso é esperado, pois o efeito do aliasing se torna mais severo com
o aumento da distancia devido a deterioraç ˆ | ao da resoluç ˜ | ao. ˜
O grafico da Figura 16, mostra que o espectro de frequ ´ | encia ˆ
do sinal adquirido difere significativamente do espectro de
alta resoluçao, com as magnitudes das frequ ˜ | encias aparecendo ˆ
substancialmente alteradas. Isso reforça a noçao de que o ˜ aliasing esta afetando a fidelidade do sinal medido. ´
Ao comparar os graficos contidos nas Figuras 11, 13 e 15 ´
observa-se uma deterioraçao da resoluç ˜ | ao com o aumento da ˜
distancia de mediç ˆ | ao, o que resulta em uma amplificaç ˜ | ao do ˜
fenomeno de aliasing. ˆ

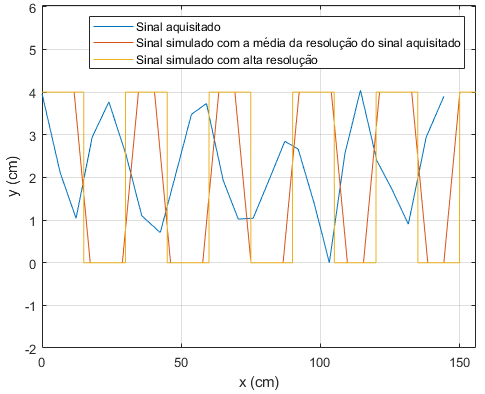
[picture p17: figure]

Figura 15. Comparaçao entre o sinal LiDAR adquirido, o sinal simulado com ˜
a media da resoluç ´ | ao do sinal adquirido e o sinal simulado com alta resoluç ˜ | aõ
a 4 metros.

Centro Federal de Educaçao Tecnol ˜ | ogica de Minas Gerais – CEFET-MG ´ | 10

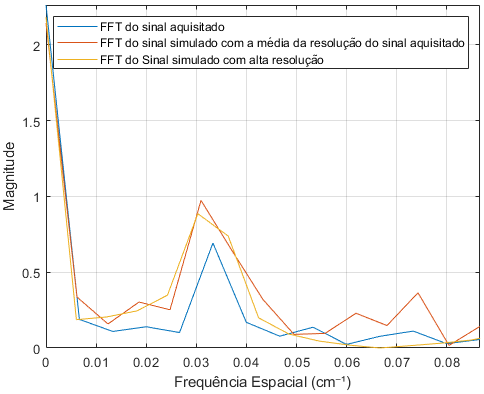
[picture p18: figure]

Figura 16. Espectro de frequencia dos sinais a 4 metros dos sinais: adquirido, ˆ
simulado com media da resoluç ´ | ao e simulado de alta resoluç ˜ | ao. ˜

IX. CONCLUSAÕ

Este Trabalho de Conclusao de Curso (TCC) apresentou ˜
o desenvolvimento e a analise de um prot ´ | otipo de scanner ´
LiDAR terrestre estacionario com o intuito de investigar a ´
influencia do aliasing espacial em funç ˆ | ao da resoluç ˜ | ao espacial ˜
e da distancia de mediç ˆ | ao. A investigaç ˜ | ao foi conduzida por ˜
meio de uma metodologia que englobou tanto experimentos
praticos quanto simulaç ´ | oes computacionais. ˜
Os dados coletados e as analises subsequentes evidencia- ´ ram que a resoluçao espacial se deteriora com o aumento ˜
da distancia de mediç ˆ | ao, exacerbando o efeito de aliasing. ˜
Esses achados sublinham a necessidade de desenvolvimento
contínuo de soluçoes que possam mitigar as limitaç ˜ | oes im- ˜
postas pelo aliasing.
Em termos de fidelidade na representaçao de ambientes por ˜ meio de nuvens de pontos, o prototipo mostrou-se competente. ´ A densidade da nuvem de pontos gerada foi substancial, permitindo uma visualizaçao detalhada dos aspectos mais re- ˜ levantes do ambiente escaneado. A qualidade da representaçaõ e evidenciada pela Figura 17, a qual ilustra a capacidade do ´ prototipo de capturar detalhes do ambiente. ´
Contudo, e importante ressaltar que fatores, como o ponto ´
de vista de observaçao dos dados, a renderizaç ˜ | | ao computacio- ˜
nal e as limitaçoes inerentes ao processamento gr ˜ | | afico, podem ´
influenciar a percepçao final dos dados visualizados. Estes ˜ fatores podem dificultar a visualizaçao de detalhes mais finos, ˜ sugerindo que a realidade capturada pelo prototipo pode ser ´ ainda mais rica em detalhes do que o apresentado na figura.
No que concerne a efici ` | encia na transmiss ˆ | ao e proces- ˜
samento dos dados em tempo real, o prototipo atendeu ´ | as`
expectativas. A transmissao de dados do sensor LiDAR para ˜ o sistema de visualizaçao, facilitada pelo uso do protocolo ˜ MQTT, ocorreu de forma fluida e eficiente.
X. AGRADECIMENTOS

Agradeço a Deus pelo meu ser e pela providencia em minha ˆ vida. Aos meus pais, pelo amor incondicional, apoio e sa-
crifícios incansaveis. Aos meus irm ´ | | aos, pelo companheirismo, ˜
apoio e por estarem sempre ao meu lado. Aos meus amigos
de republica, que s ´ | ao uma fam ˜ | ília que escolhi ter em minha
vida e sou muito grato por cada momento compartilhado. Ao meu colega de curso Frederico, pela sua ajuda e apoio no desenvolvimento deste trabalho. A todos os envolvidos no meu
primeiro estagio, por me acolherem t ´ | | ao bem e me propor- ˜
cionarem uma experiencia profissional valiosa; voc ˆ | es foram ˆ
fundamentais para o meu crescimento pessoal e profissional.
Aos professores Everthon e Tulio, pelo ensino, orientaç ´ | ao e ˜
inspiraçao. A todos que de alguma forma contribu ˜ | | íram com
o meu progresso, e a mim mesmo, por nunca desistir, mesmo diante das adversidades que surgiram em meu caminho.

REFERENCIAS ˆ

[1] D. D. Lichti and S. Jamtsho, “Angular Resolution of Terrestrial Laser Scanners,” The Photogrammetric Record, vol. 21, no. 114, pp. 141-160, Jun. 2006. Disponível em: https://bit.ly/46X6HIW
[2] C. E. Shannon, “Communication in the presence of noise,” IEEE, vol. 86, no. 2, pp. 447-457, Fev. 1998. Disponível em: https://bit.ly/3tFiltI
[3] J. Carter, et al., “Lidar 101: An Introduction to Lidar Technology, Data, and Applications,” NOAA Coastal Services Center, Charleston, SC, USA, Nov. 2012.
[4] P. J. Besl, “Surfaces in Range Image Understanding,” Springer-Verlag, New York, 1988.
[5] D. A. P. Ferreira, “Analise e processamento de sinais,” Editora e ´ Distribuidora Educacional S/A, Londrina, 2018.
[6] S. Haykin e B. Van Veen, “Sinais e Sistemas,” Bookman, Porto Alegre, 2001.
[7] R. T. Higuti e C. Kitano, “Sinais e sistemas,” Editora UNESP, Sao Paulo, ˜ 2003.
[8] B. P. Lathi, “Sinais e sistemas lineares,” Bookman, Porto Alegre, 2008.
[9] A. V. Oppenheim and A. S. Willsky, “Sinais e sistemas,” Pearson Prentice Hall, Sao Paulo, 2010. ˜
[10] R. C. Gonzalez e R. E. Woods, “Processamento de Imagens Digitais,”
Editora Edgard Blucher Ltda., S ¨ | ao Paulo, Brasil, 2000. ˜
[11] H. Nyquist, “Certain topics in telegraph transmission theory,” Trans. AIEE, vol. 47, pp. 617-644, 1928. Reprinted as a classic paper in: Proc. IEEE, vol. 90, no. 2, Feb. 2002.
[12] M. Melin et al., “Conservation Technology Remote Sensing: LiDAR,” Vol. 1 N.3, WWF Conservation Technology Series, Woking, Surrey, United Kingdom, 2017.
[13] G. Vosselman and H.-G. Maas, “Airborne and Terrestrial Laser Scanning,” Whittles Publishing, Dunbeath, Caithness, Scotland, UK, 2010.

Centro Federal de Educaçao Tecnol ˜ | ogica de Minas Gerais – CEFET-MG ´ | 11

APENDICE ˆ

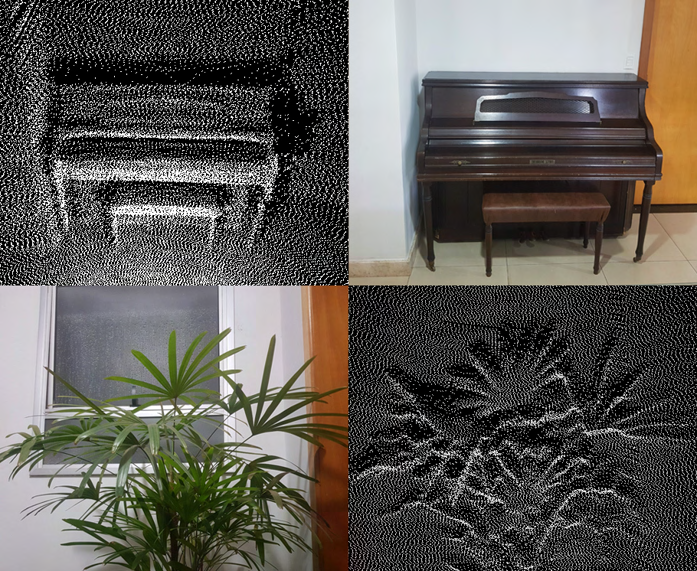
[picture p19: figure]

Figura 17. Comparativos entre captura do prototipo e imagem original da ´ cena.

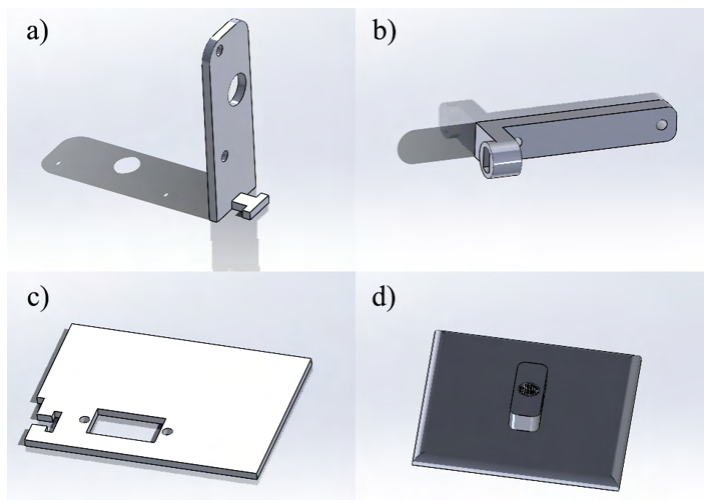
[picture p20: figure]

Figura 18. Componentes da estrutura do prototipo: a) Suporte do motor de ´ passo; b) Eixo do motor de passo e suporte do sensor TF-Luna; c) Plataforma base do prototipo com encaixes para o servomotor e para o suporte do motor ´ de passo; d) Suporte base do prototipo. ´

Tabela III
TABELA DE COMPONENTES ELETRONICOS COM ˆ | PREÇ OS LOCAIS DE 2023
Componente | Un. | Preço por Un. (R$)
Motor de Passo 28BYJ-48 | 1 | 13,77
Servomotor SG92R | 1 | 28,41
Sensor AS5600 | 1 | 28,00
Sensor TF-Luna | 1 | 228,00
Celula de L ´ ítio 500 mAh | 4 | 36,00
Modulo Carregador TP4056 | 1 | 9,99
Modulo Regulador Step-up 5 V XR2981 ´ | 1 | 28,46
Regulador Step-down 3,3 V AMS1117 | 1 | 3,00
Driver ULN2003AD | 1 | 1,45
ESP32-WROOM-32D | 1 | 44,56
Fim de Curso | 1 | 2,90
Capacitor de Tantalo 100 nF ˆ | 1 | 5,32
Chave Tactil SMD KFC-A06 ´ | 1 | 0,35
Chave SS12D07VG4 | 1 | 0,57
Resistor SMD 120 kΩ | 2 | 0,48
Resistor SMD 10 kΩ | 1 | 0,05
Capacitor Ceramico SMD 0,1 uF ˆ | 3 | 0,26
Capacitor Ceramico SMD 1 uF ˆ | 1 | 0,30
Capacitor Ceramico SMD 10 uF ˆ | 1 | 0,22
Impressao 3D ˜ | - | 5,00
Placas de Circuito Impresso | - | 10,00
Cabos | - | 2,00
Total | | R$ 558,09
