lanacif/Single-Point-LiDAR-Scanner/imgs/Estrutura.png

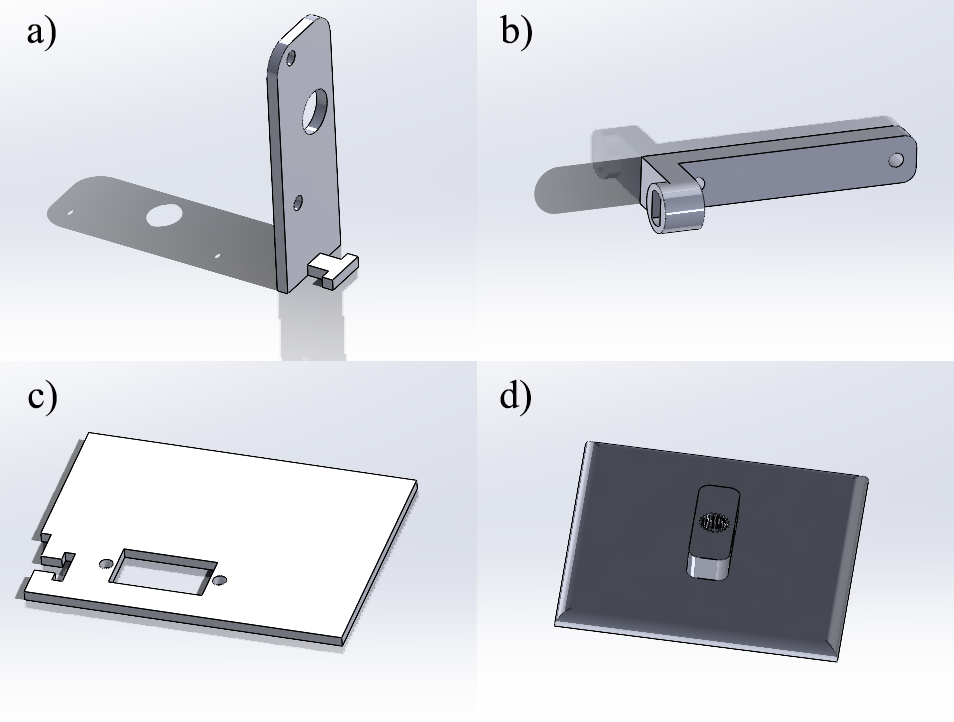
imgs/Estrutura.png
