lanacif/Single-Point-LiDAR-Scanner/Modelo 3D Estrutura V2/LiDAR Final V2.SLDPRT

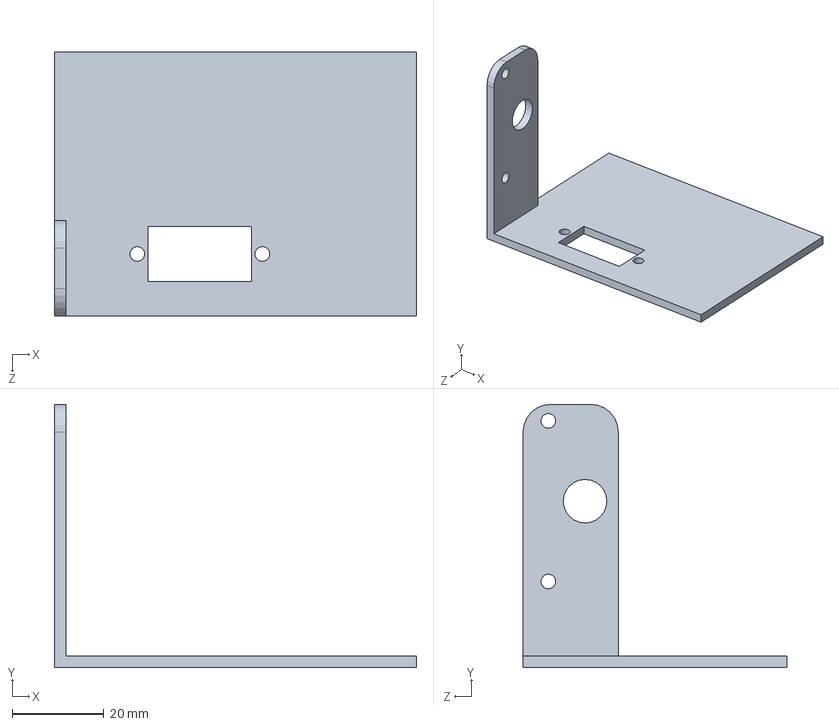
[picture p31: CAD file, 2024-11-20]
Modelo 3D Estrutura V2/LiDAR Final V2.SLDPRT
78.9 x 57.4 x 57.5 mm
