lanacif/Single-Point-LiDAR-Scanner/Modelo 3D Estrutura V2/BaseInferior V2.SLDPRT

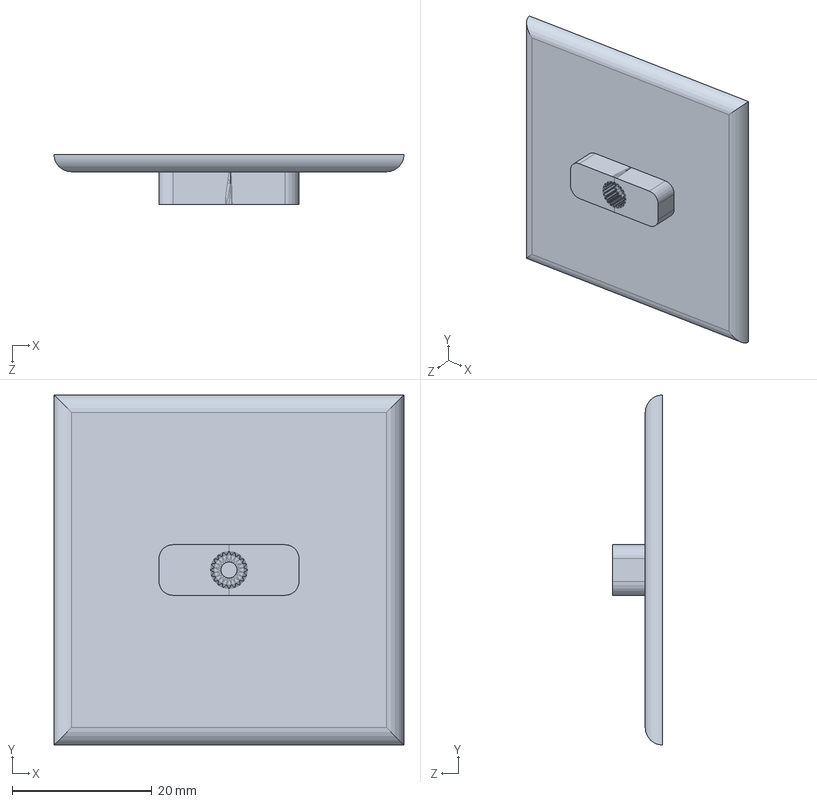
[picture p32: CAD file, 2024-11-20]
Modelo 3D Estrutura V2/BaseInferior V2.SLDPRT
50.0 x 50.0 x 7.19 mm
