lanacif/Single-Point-LiDAR-Scanner/Modelo 3D Estrutura V2/LiDAR Final V2 - Base.SLDPRT

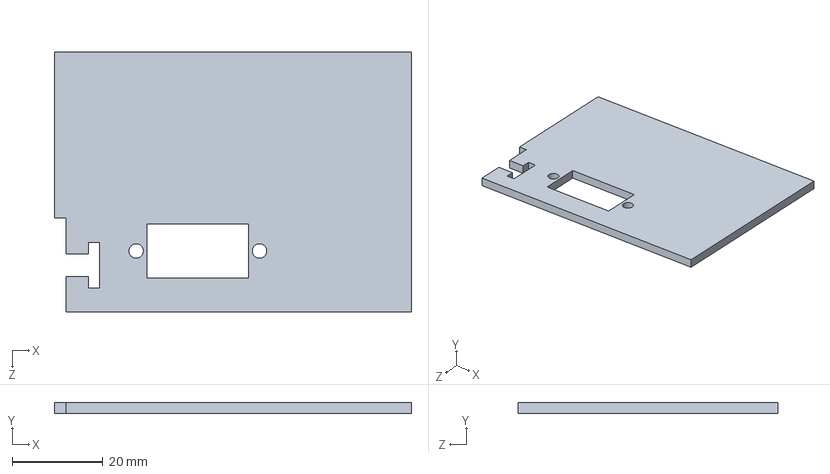
[picture p33: CAD file, 2024-11-20]
Modelo 3D Estrutura V2/LiDAR Final V2 - Base.SLDPRT
78.9 x 2.50 x 57.5 mm
