lanacif/Single-Point-LiDAR-Scanner/Modelo 3D Estrutura V2/BraçoSingle V2.SLDPRT

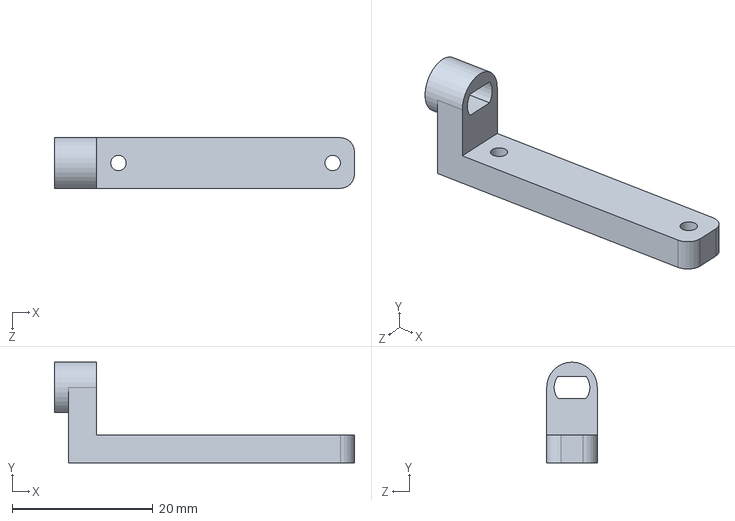
[picture p34: CAD file, 2024-11-20]
Modelo 3D Estrutura V2/BraçoSingle V2.SLDPRT
42.7 x 14.3 x 7.20 mm
