lanacif/Single-Point-LiDAR-Scanner/Modelo 3D Estrutura V2/LiDAR Final V2 - SuporteMotor.SLDPRT

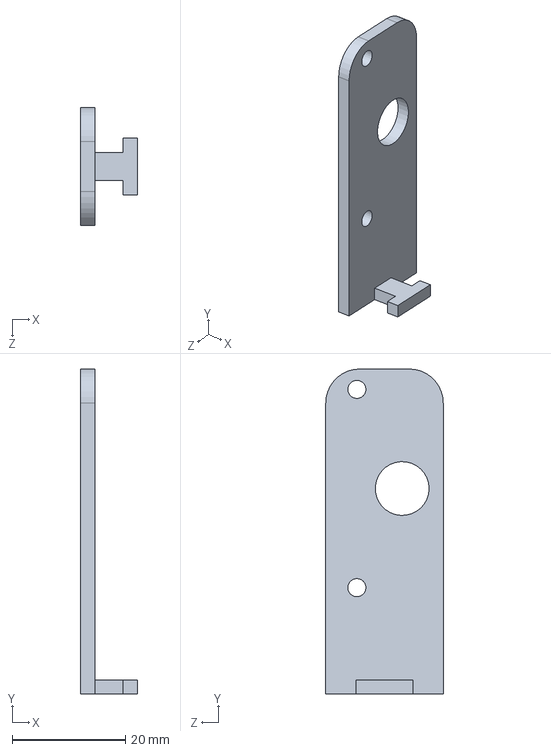
[picture p35: CAD file, 2024-11-20]
Modelo 3D Estrutura V2/LiDAR Final V2 - SuporteMotor.SLDPRT
10.0 x 57.4 x 20.8 mm
