lanacif/Single-Point-LiDAR-Scanner/(list of files, drawings)

Other design files:
Esquema Elétrico/LiDAR.pdsprj
